smssocoaches-cell/ELG/ELG_Dial_Detail.png

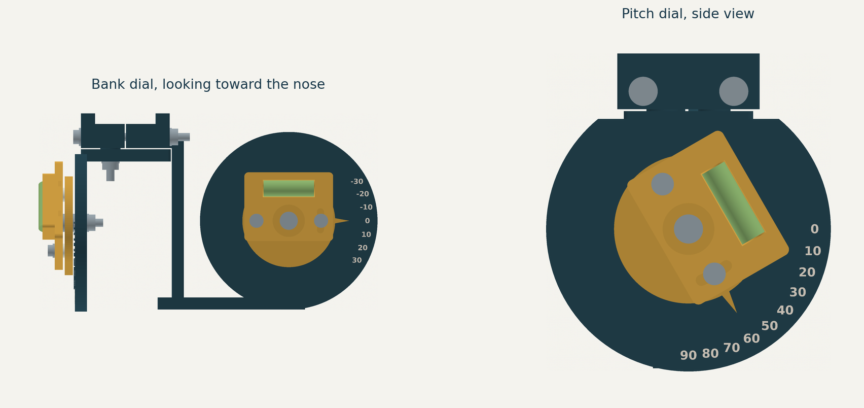
ELG_Dial_Detail.png
