smssocoaches-cell/ELG/ELG_Launcher_v04_Preview.png

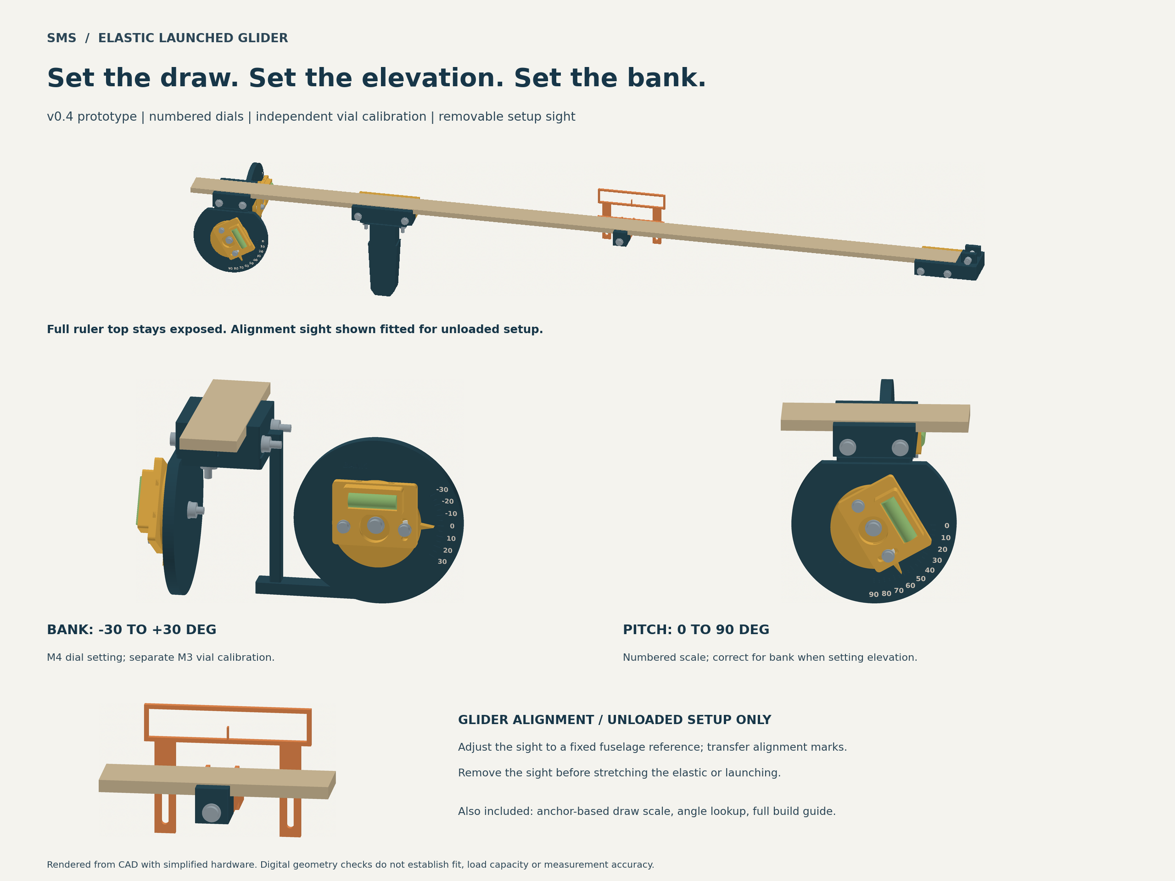
ELG_Launcher_v04_Preview.png
