smssocoaches-cell/ELG/ELG_Launcher_Assembly.step

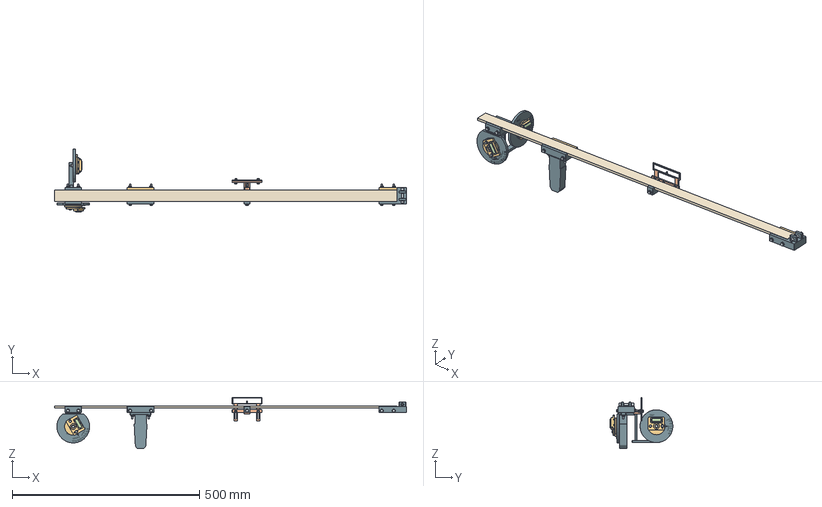
[picture p3: CAD file, 2026-10-14]
ELG_Launcher_Assembly.step
940.4 x 168.0 x 137.0 mm
wood_ruler
01_grip_fixed_jaw
02_grip_moving_jaw
03_grip_handle
04_anchor_fixed_jaw_and_nose
05_anchor_moving_jaw
06_marker_fixed_jaw
07_marker_moving_jaw
08_gauge_fixed_jaw
09_gauge_moving_jaw_roll_bracket
10_pitch_bracket
11_pitch_rotor_calibration_base
15_bank_rotor_calibration_base
16_removable_alignment_sight
sight_shank0
sight_head0
sight_washer0_0
sight_washer0_1
sight_nut0
sight_shank1
sight_head1
sight_washer1_0
sight_washer1_1
sight_nut1
pitch_calibration_carrier
pitch_vial_reference
pitch_nylon_spacer0
pitch_outer_washer0
pitch_trim_shank0
pitch_trim_head0
pitch_trim_nut0
pitch_nylon_spacer1
pitch_outer_washer1
pitch_trim_shank1
pitch_trim_head1
pitch_trim_nut1
roll_calibration_carrier
roll_vial_reference
roll_nylon_spacer0
roll_outer_washer0
roll_trim_shank0
roll_trim_head0
roll_trim_nut0
roll_nylon_spacer1
roll_outer_washer1
roll_trim_shank1
roll_trim_head1
roll_trim_nut1
pitch_pivot_spacer
roll_pivot_spacer
pitch_pivot_front_washer
roll_pivot_front_washer
pitch_pivot_rear_washer
roll_pivot_rear_washer
pitch_pivot_shank
roll_pivot_shank
pitch_pivot_head
roll_pivot_head
pitch_pivot_nut
roll_pivot_nut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
