smssocoaches-cell/ELG/STEP/14_calibration_vial_carrier_PRINT_2.step

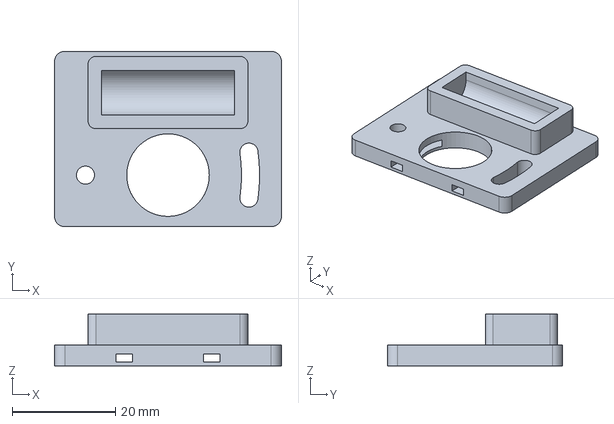
[picture p4: CAD file, 2026-10-14]
STEP/14_calibration_vial_carrier_PRINT_2.step
44.0 x 34.0 x 10.0 mm
