smssocoaches-cell/ELG/STEP/16_removable_alignment_sight.step

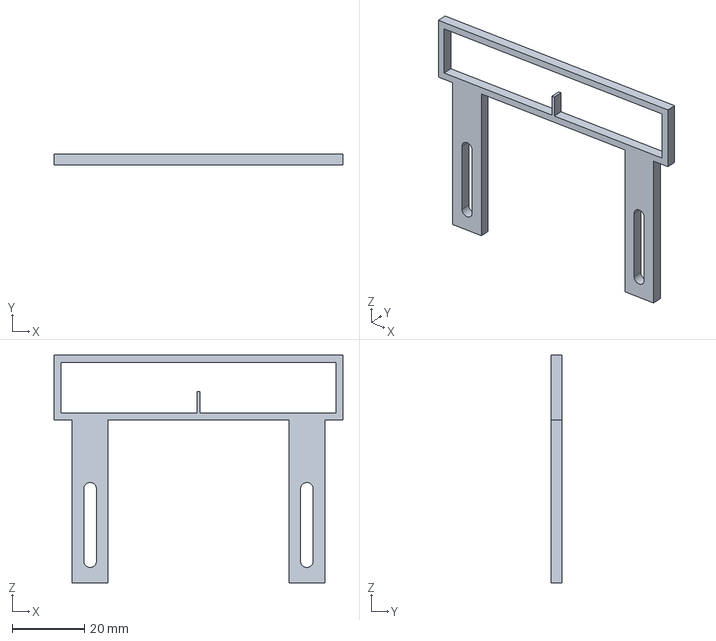
[picture p5: CAD file, 2026-10-14]
STEP/16_removable_alignment_sight.step
80.0 x 3.00 x 63.0 mm
