smssocoaches-cell/ELG/STEP/15_bank_rotor_calibration_base.step

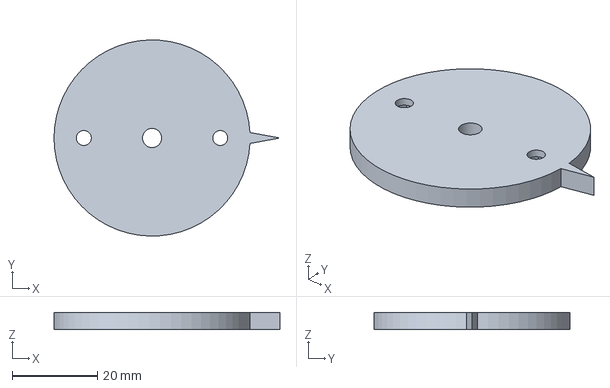
[picture p6: CAD file, 2026-10-14]
STEP/15_bank_rotor_calibration_base.step
53.0 x 46.0 x 4.00 mm
