smssocoaches-cell/ELG/STEP/12_fit_coupon_fixed_jaw.step

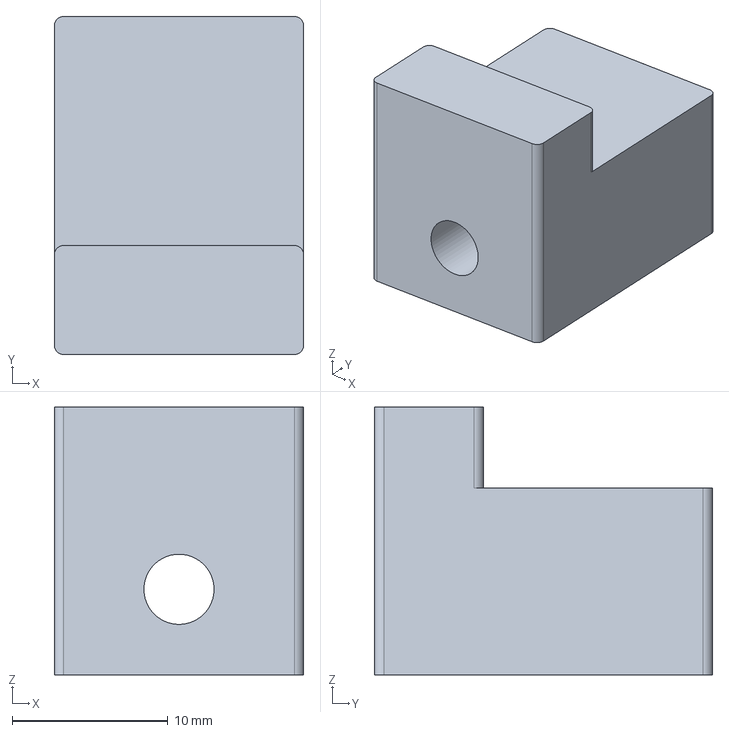
[picture p7: CAD file, 2026-10-14]
STEP/12_fit_coupon_fixed_jaw.step
16.0 x 21.7 x 17.2 mm
