smssocoaches-cell/ELG/STEP/08_gauge_fixed_jaw.step

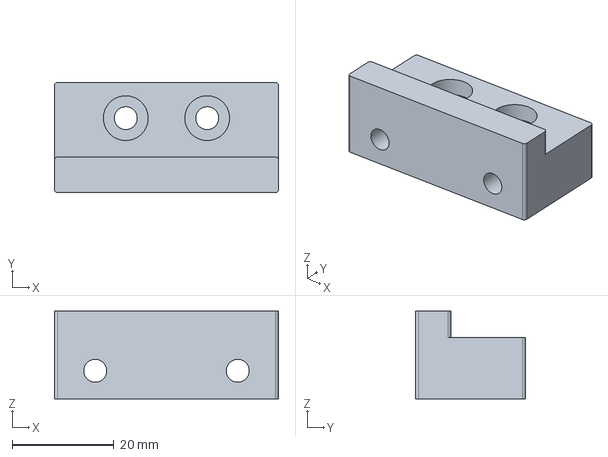
[picture p8: CAD file, 2026-10-14]
STEP/08_gauge_fixed_jaw.step
44.0 x 21.7 x 17.2 mm
