smssocoaches-cell/ELG/STEP/07_marker_moving_jaw.step

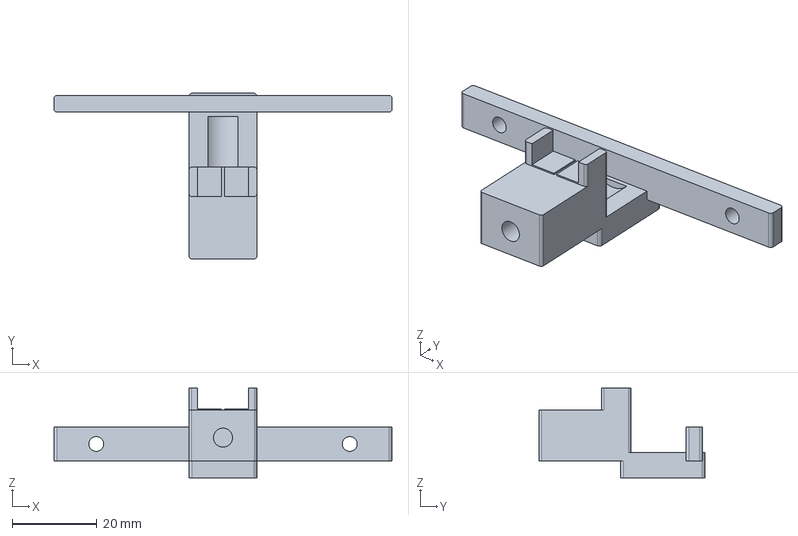
[picture p9: CAD file, 2026-10-14]
STEP/07_marker_moving_jaw.step
80.0 x 39.2 x 21.2 mm
