smssocoaches-cell/ELG/STEP/02_grip_moving_jaw.step

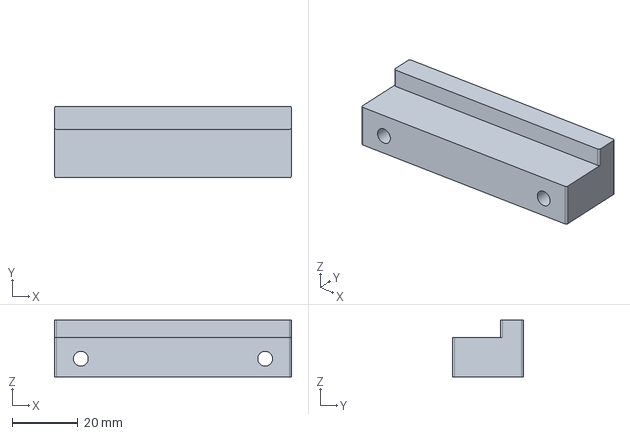
[picture p10: CAD file, 2026-10-14]
STEP/02_grip_moving_jaw.step
72.0 x 21.7 x 17.2 mm
