smssocoaches-cell/ELG/STEP/04_anchor_fixed_jaw_and_nose.step

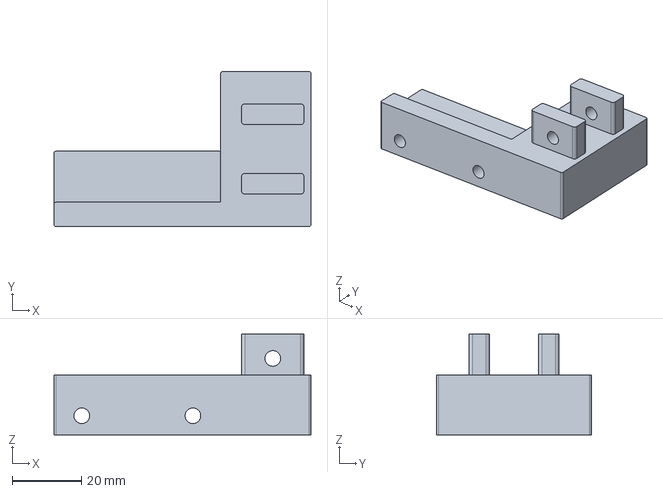
[picture p11: CAD file, 2026-10-14]
STEP/04_anchor_fixed_jaw_and_nose.step
74.0 x 44.6 x 29.0 mm
