smssocoaches-cell/ELG/STEP/01_grip_fixed_jaw.step

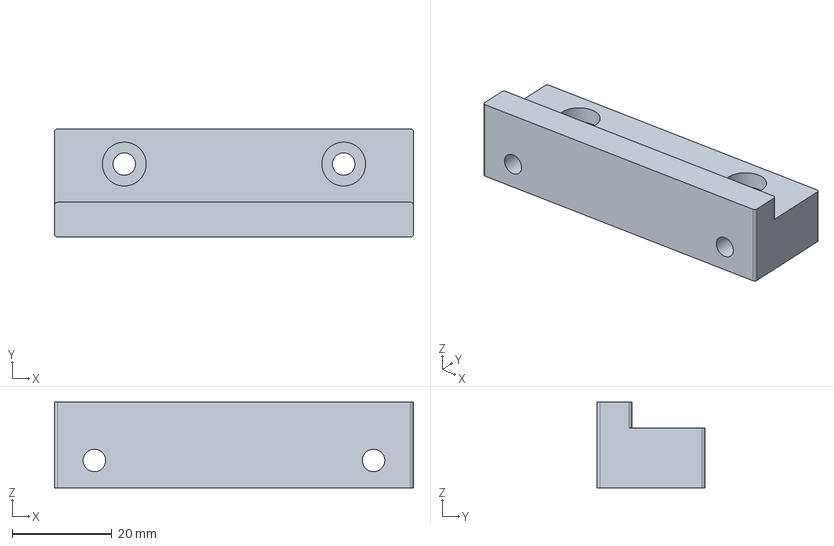
[picture p12: CAD file, 2026-10-14]
STEP/01_grip_fixed_jaw.step
72.0 x 21.7 x 17.2 mm
