smssocoaches-cell/ELG/STEP/05_anchor_moving_jaw.step

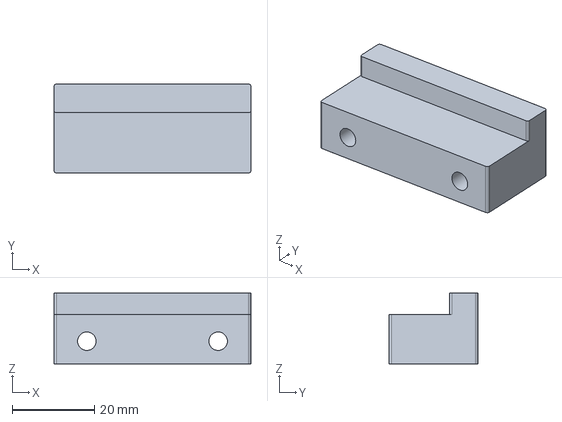
[picture p13: CAD file, 2026-10-14]
STEP/05_anchor_moving_jaw.step
48.0 x 21.7 x 17.2 mm
