smssocoaches-cell/ELG/STEP/03_grip_handle.step

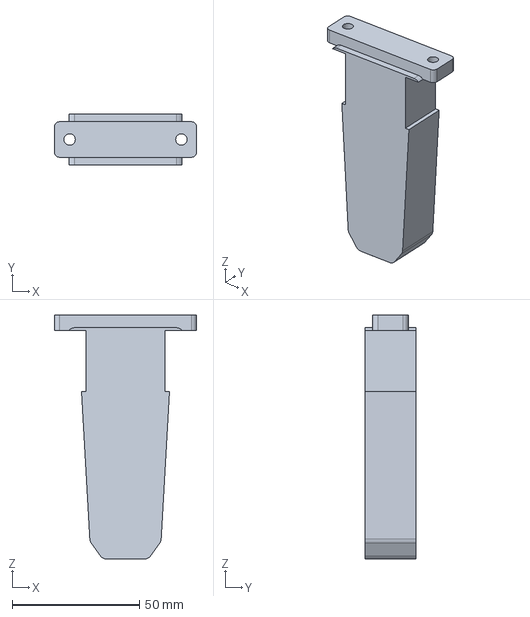
[picture p14: CAD file, 2026-10-14]
STEP/03_grip_handle.step
56.0 x 20.0 x 96.0 mm
