smssocoaches-cell/ELG/STEP/09_gauge_moving_jaw_roll_bracket.step

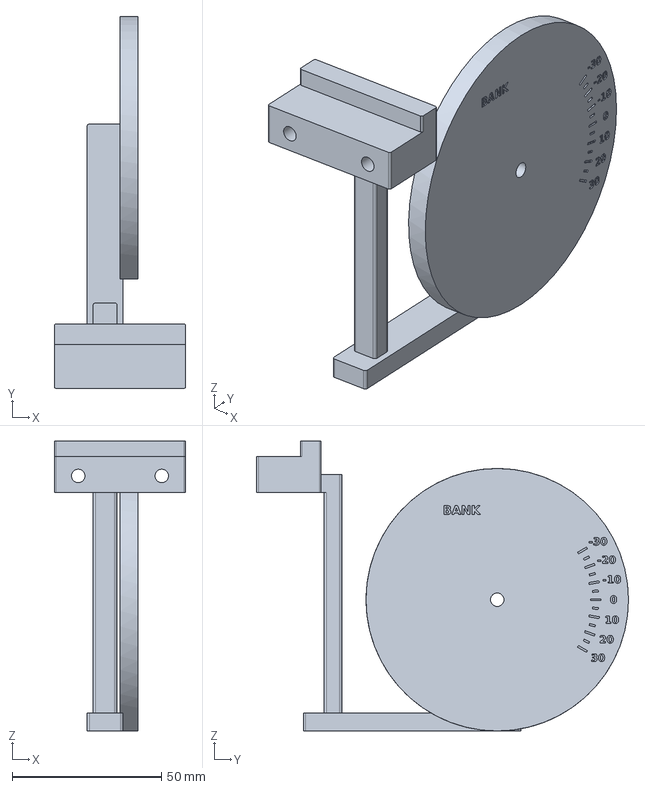
[picture p15: CAD file, 2026-10-14]
STEP/09_gauge_moving_jaw_roll_bracket.step
44.0 x 124.7 x 97.2 mm
