smssocoaches-cell/ELG/STEP/10_pitch_bracket.step

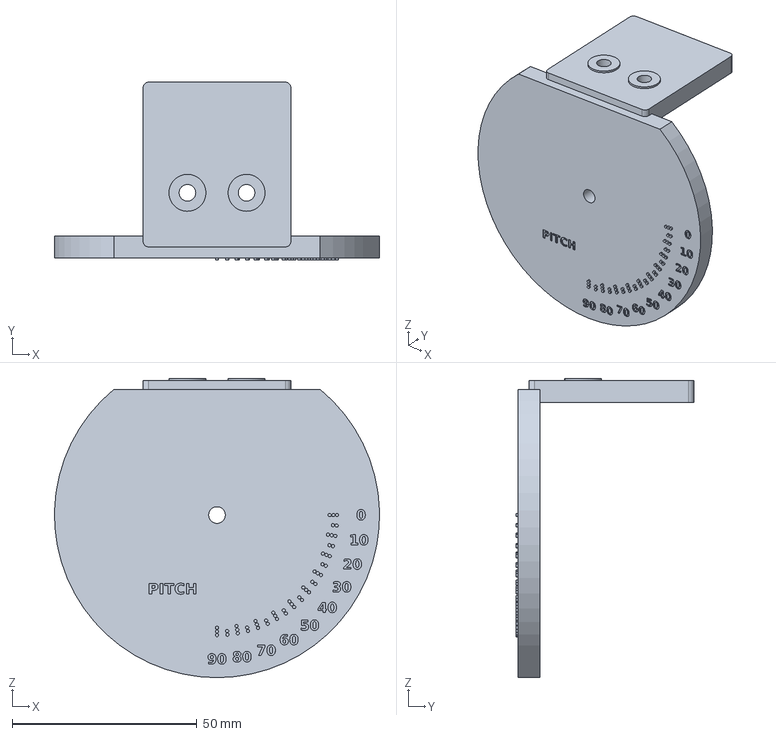
[picture p16: CAD file, 2026-10-14]
STEP/10_pitch_bracket.step
88.0 x 48.1 x 81.0 mm
