smssocoaches-cell/ELG/(list of files, cad)

Other CAD files:
STEP/13_fit_coupon_moving_jaw.step
STEP/06_marker_fixed_jaw.step
STEP/11_pitch_rotor_calibration_base.step
STL/01_grip_fixed_jaw.stl
STL/02_grip_moving_jaw.stl
STL/03_grip_handle.stl
STL/04_anchor_fixed_jaw_and_nose.stl
STL/05_anchor_moving_jaw.stl
STL/06_marker_fixed_jaw.stl
STL/07_marker_moving_jaw.stl
STL/08_gauge_fixed_jaw.stl
STL/09_gauge_moving_jaw_roll_bracket.stl
STL/10_pitch_bracket.stl
STL/11_pitch_rotor_calibration_base.stl
STL/12_fit_coupon_fixed_jaw.stl
STL/13_fit_coupon_moving_jaw.stl
STL/14_calibration_vial_carrier_PRINT_2.stl
STL/15_bank_rotor_calibration_base.stl
STL/16_removable_alignment_sight.stl
