smssocoaches-cell/ELG/ELG_Axial_Draw_Scale_Print_100pct.pdf

# ELG v0.4 | Axial draw scale

PRINT AT 100% / ACTUAL SIZE. Disable Fit to page. Check the 100 mm bar below.
Readout = distance along ruler from hook station to anchor-pin center (mm).
This is not the rubber path length. Pullback extension = loaded reading - relaxed reading. Attach to the SIDE with segment 1 start at the wooden ruler front end. Values grow rearward. Overlap successive strips by 10 mm using matching ticks; trim only after checking alignment.
Segment 1: 0 to 200 mm behind front end | readout 15 to 215
20 | 30 | 40 | 50 | 60 | 70 | 80 | 90 | 100 | 110 | 120 | 130 | 140 | 150 | 160 | 170 | 180 | 190 | 200 | 210
FRONT END: readout starts at 15 mm; the pin center is 15 mm beyond the wood.
Segment 2: 190 to 390 mm behind front end | readout 205 to 405
210 | 220 | 230 | 240 | 250 | 260 | 270 | 280 | 290 | 300 | 310 | 320 | 330 | 340 | 350 | 360 | 370 | 380 | 390 | 400
Segment 3: 380 to 580 mm behind front end | readout 395 to 595
400 | 410 | 420 | 430 | 440 | 450 | 460 | 470 | 480 | 490 | 500 | 510 | 520 | 530 | 540 | 550 | 560 | 570 | 580 | 590
Segment 4: 570 to 770 mm behind front end | readout 585 to 785
590 | 600 | 610 | 620 | 630 | 640 | 650 | 660 | 670 | 680 | 690 | 700 | 710 | 720 | 730 | 740 | 750 | 760 | 770 | 780
Segment 5: 760 to 914.4 mm behind front end | readout 775 to 929.4
780 | 790 | 800 | 810 | 820 | 830 | 840 | 850 | 860 | 870 | 880 | 890 | 900 | 910 | 920

Size check: the line below must measure exactly 100 mm.

Default wood length: 914.4 mm. The scale is specific to this anchor geometry.
Align marker center with the selected readout. Keep tape and paper below the top plane.
Ruler axes: rear x = 0, front x = L; hook station = xH; axial reading D = L + 15 - xH.
For actual straight endpoint distance include measured vertical and lateral offsets.
Do not infer elastic force from length; record the rubber ID, relaxed zero and measured load separately.
